SartoriDynamics/Reaction-Wheel-Balanced-Bicycle/Python codes/controle_vel.pdf

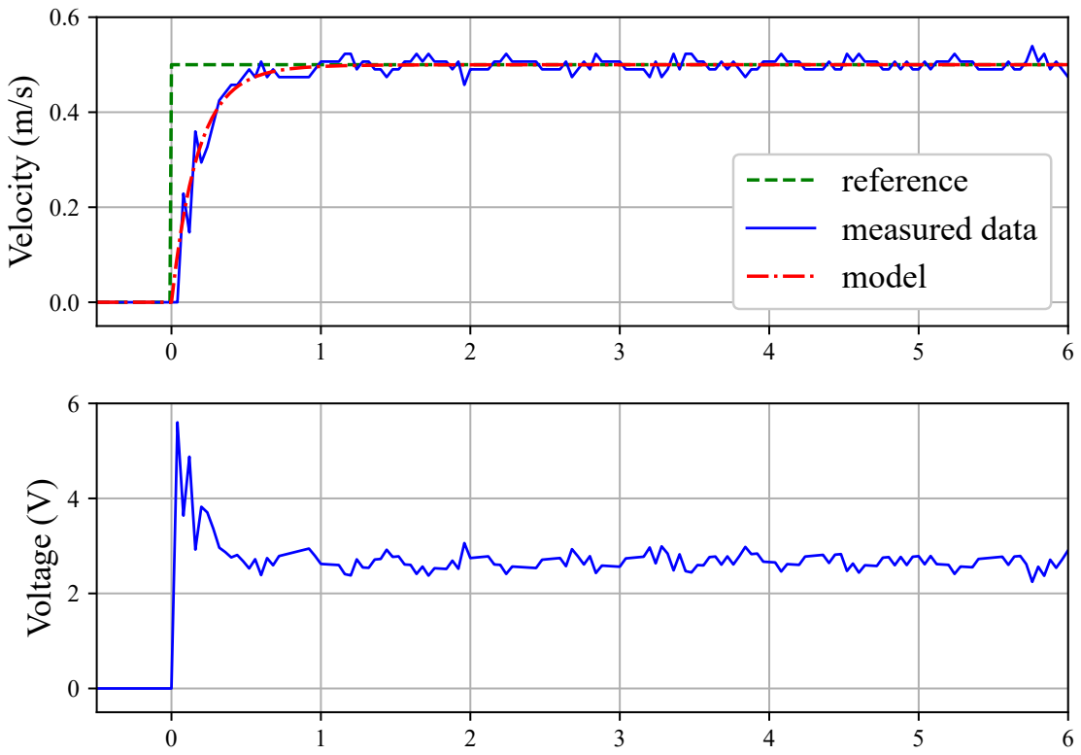
[picture p3: figure]
Velocity (m/s); reference measured data model; Voltage (V)
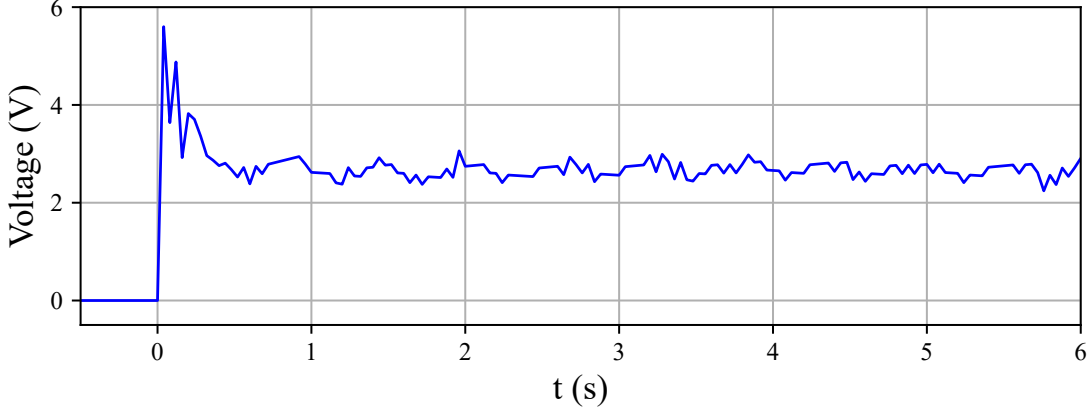
[picture p4: figure]
