SartoriDynamics/Reaction-Wheel-Balanced-Bicycle/3D printing files/Extra/rear_wheel_axle.stl

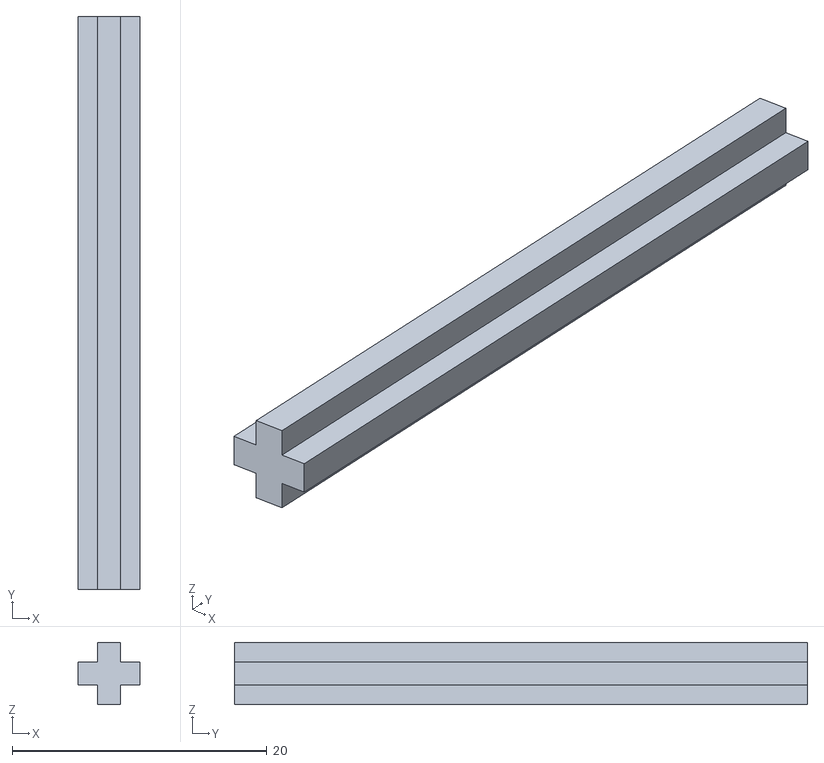
[picture p5: CAD file, 2026-11-06]
3D printing files/Extra/rear_wheel_axle.stl
4.90 x 45.0 x 4.90
