SartoriDynamics/Reaction-Wheel-Balanced-Bicycle/3D printing files/pulley_spacer.stl

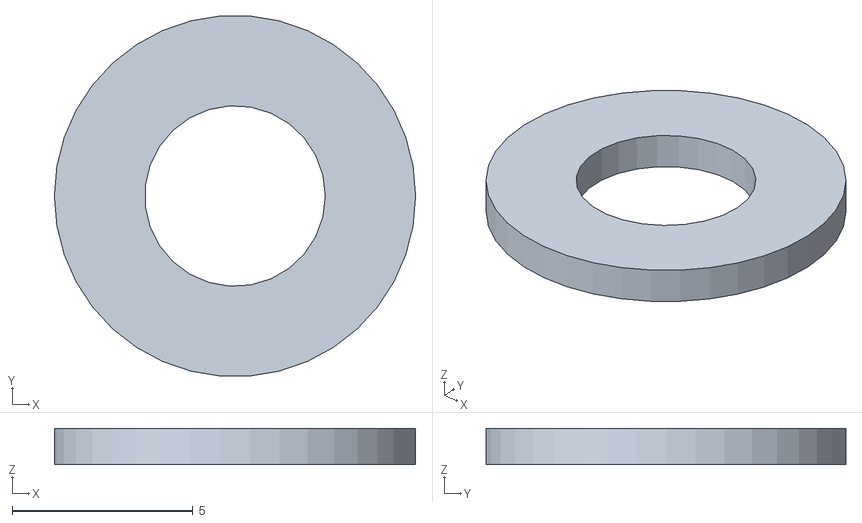
[picture p6: CAD file, 2026-11-06]
3D printing files/pulley_spacer.stl
10.0 x 9.97 x 1.00
