SartoriDynamics/Reaction-Wheel-Balanced-Bicycle/3D printing files/Extra/front_wheel_axle.stl

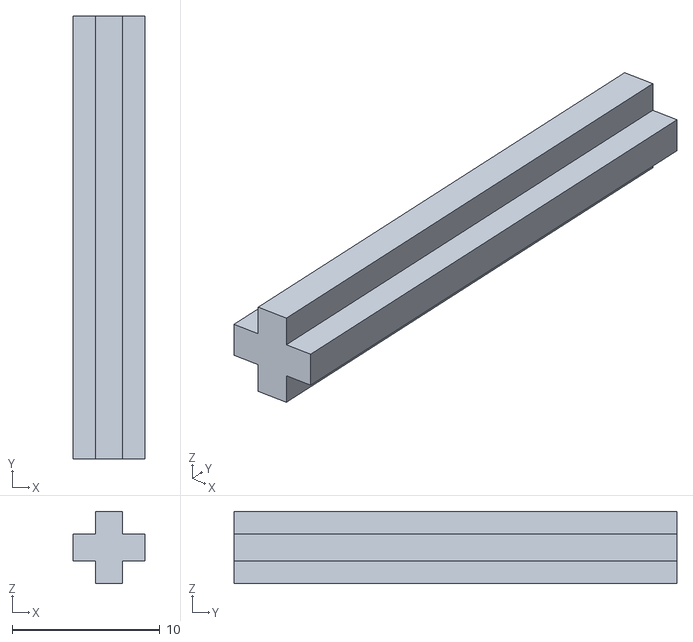
[picture p7: CAD file, 2026-11-06]
3D printing files/Extra/front_wheel_axle.stl
4.90 x 30.0 x 4.90
