SartoriDynamics/Reaction-Wheel-Balanced-Bicycle/3D printing files/rear_wheel_pulley.stl

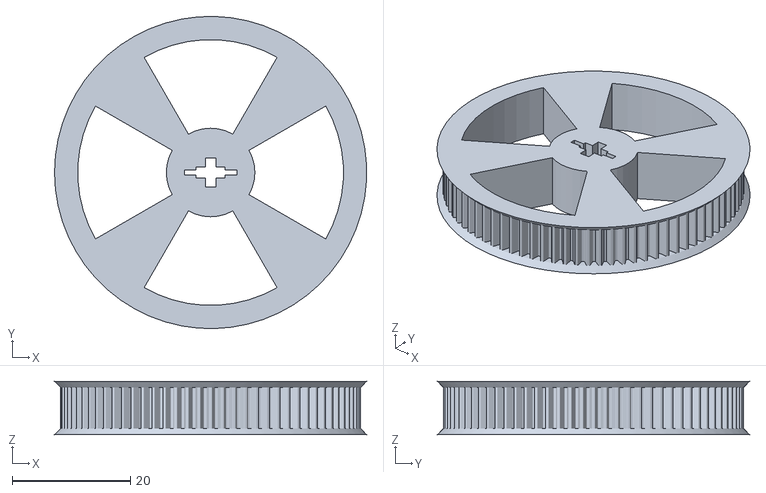
[picture p8: CAD file, 2026-11-06]
3D printing files/rear_wheel_pulley.stl
52.8 x 52.8 x 9.00
