SartoriDynamics/Reaction-Wheel-Balanced-Bicycle/3D printing files/Extra/wheel.stl

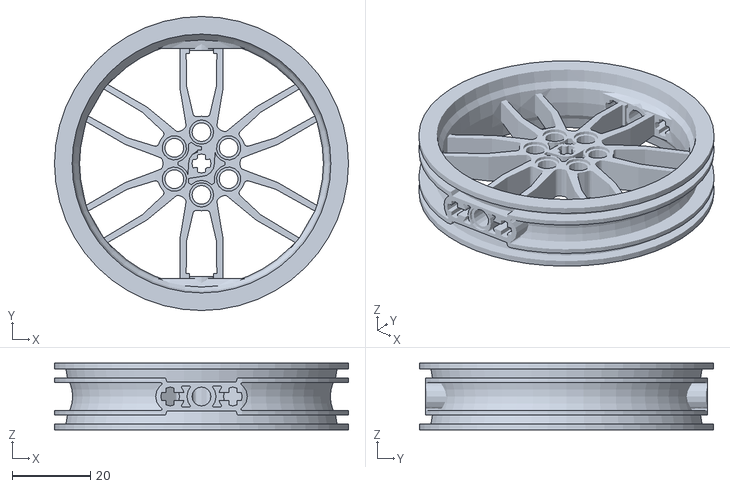
[picture p9: CAD file, 2026-11-06]
3D printing files/Extra/wheel.stl
75.0 x 75.0 x 17.0
