SartoriDynamics/Reaction-Wheel-Balanced-Bicycle/3D printing files/rear_servo_mount.stl

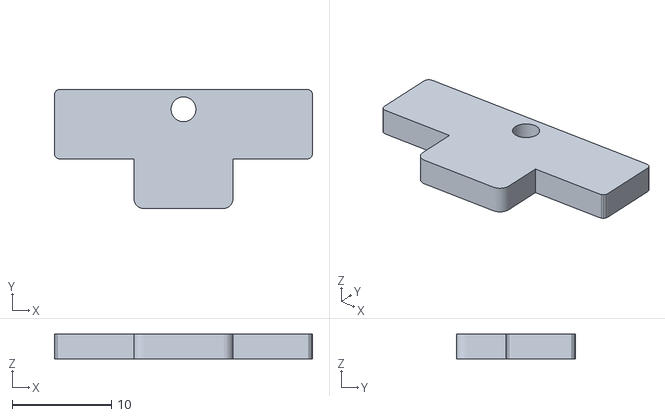
[picture p10: CAD file, 2026-11-06]
3D printing files/rear_servo_mount.stl
26.0 x 12.0 x 2.50
