SartoriDynamics/Reaction-Wheel-Balanced-Bicycle/3D printing files/Extra/tire.stl

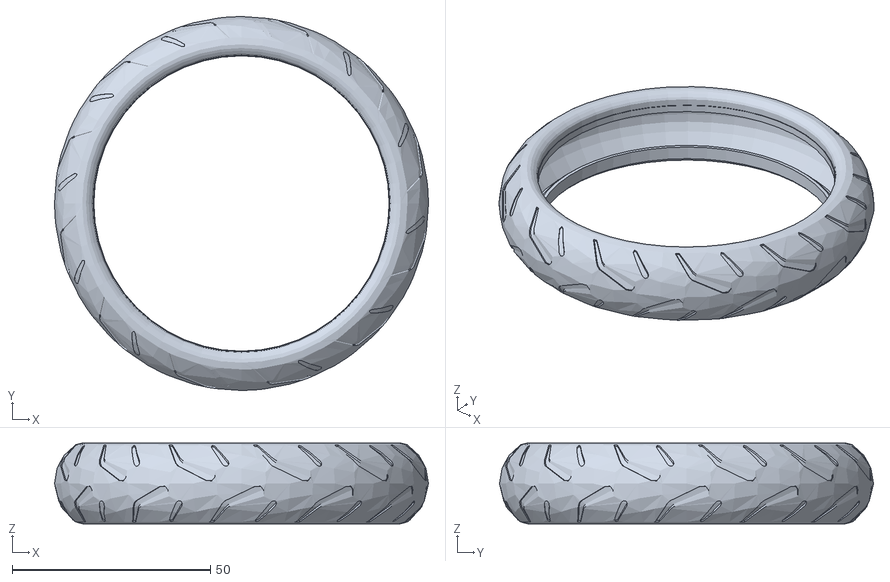
[picture p11: CAD file, 2026-11-06]
3D printing files/Extra/tire.stl
94.3 x 94.3 x 20.4
