SartoriDynamics/Reaction-Wheel-Balanced-Bicycle/3D printing files/motor_mounting_plate.stl

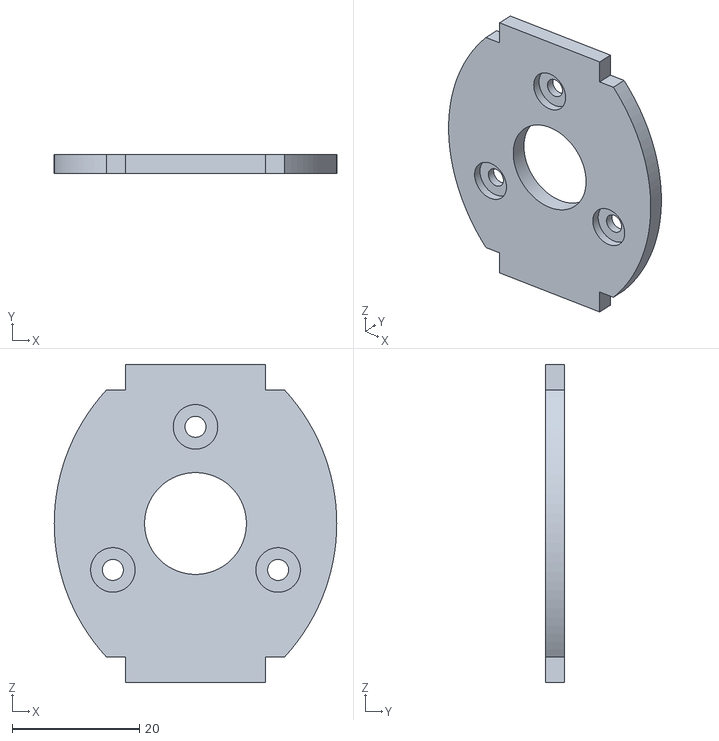
[picture p12: CAD file, 2026-11-06]
3D printing files/motor_mounting_plate.stl
44.4 x 3.00 x 50.0
