SartoriDynamics/Reaction-Wheel-Balanced-Bicycle/3D printing files/front_servo_mount.stl

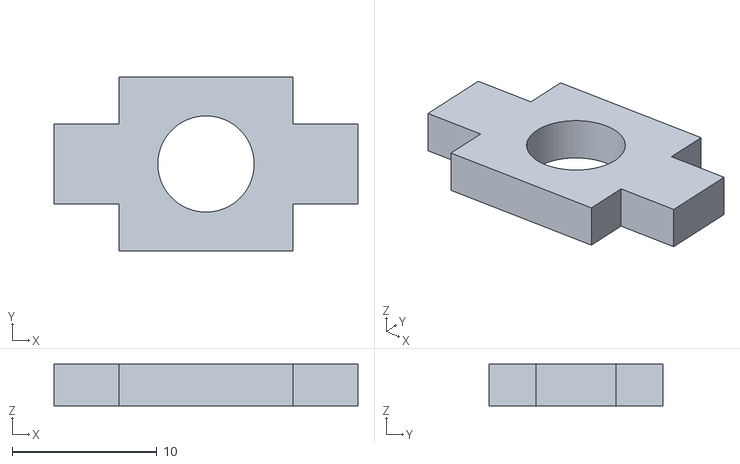
[picture p13: CAD file, 2026-11-06]
3D printing files/front_servo_mount.stl
21.0 x 12.0 x 2.90
