SartoriDynamics/Reaction-Wheel-Balanced-Bicycle/3D printing files/motor_drive_hub.stl

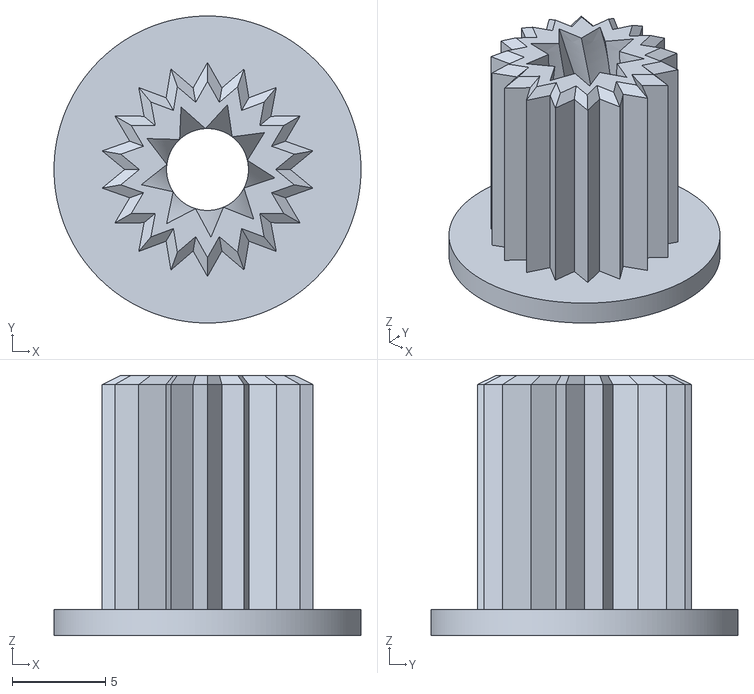
[picture p14: CAD file, 2026-11-06]
3D printing files/motor_drive_hub.stl
16.5 x 16.5 x 14.0
