SartoriDynamics/Reaction-Wheel-Balanced-Bicycle/3D printing files/left_frame_plate.stl

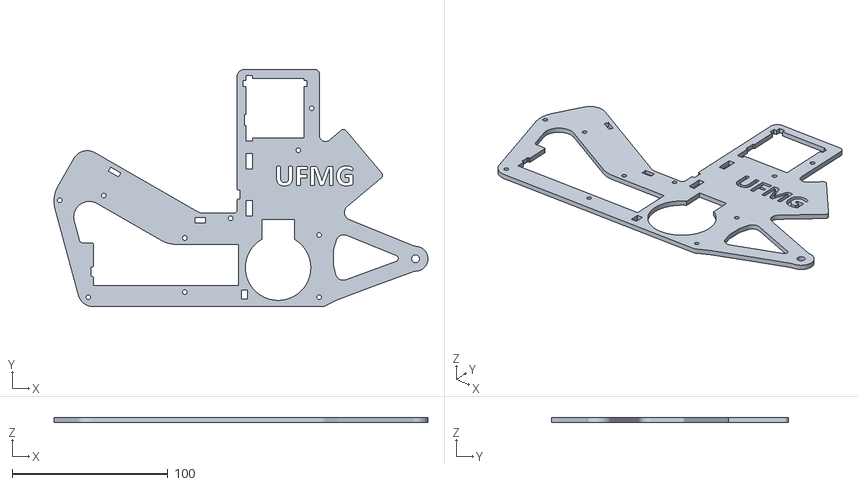
[picture p15: CAD file, 2026-11-06]
3D printing files/left_frame_plate.stl
240.4 x 152.5 x 3.00
