SartoriDynamics/Reaction-Wheel-Balanced-Bicycle/3D printing files/lower_servo_mount.stl

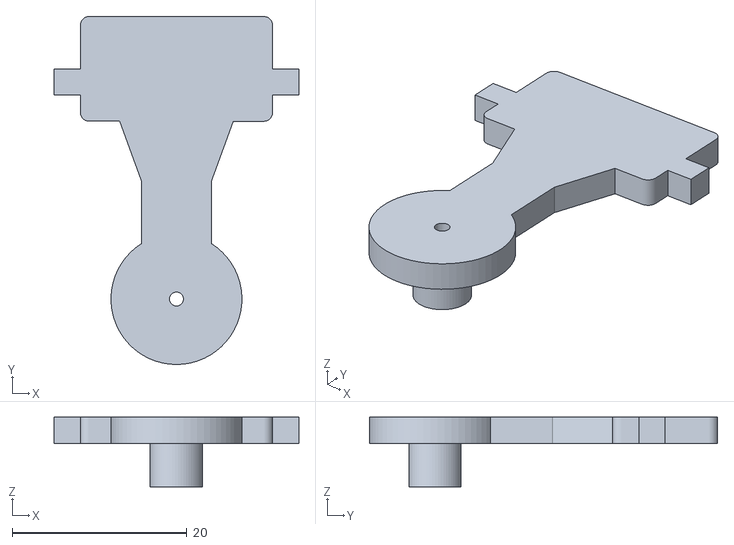
[picture p16: CAD file, 2026-11-06]
3D printing files/lower_servo_mount.stl
28.0 x 39.8 x 8.00
