SartoriDynamics/Reaction-Wheel-Balanced-Bicycle/3D printing files/right_frame_plate.stl

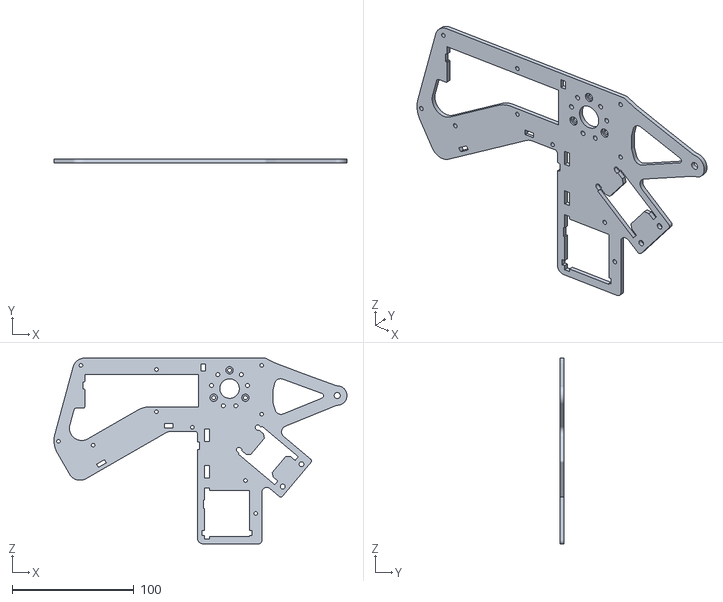
[picture p17: CAD file, 2026-11-06]
3D printing files/right_frame_plate.stl
240.4 x 3.00 x 152.5
