SartoriDynamics/Reaction-Wheel-Balanced-Bicycle/3D printing files/reaction_wheel.stl

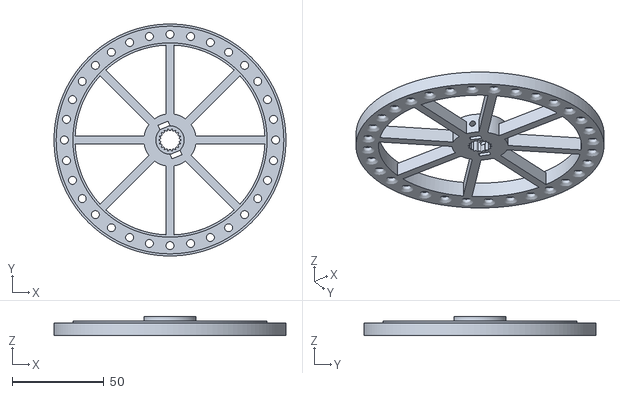
[picture p18: CAD file, 2026-11-06]
3D printing files/reaction_wheel.stl
126.4 x 126.4 x 10.5
