SartoriDynamics/Reaction-Wheel-Balanced-Bicycle/3D printing files/upper_servo_mount.stl

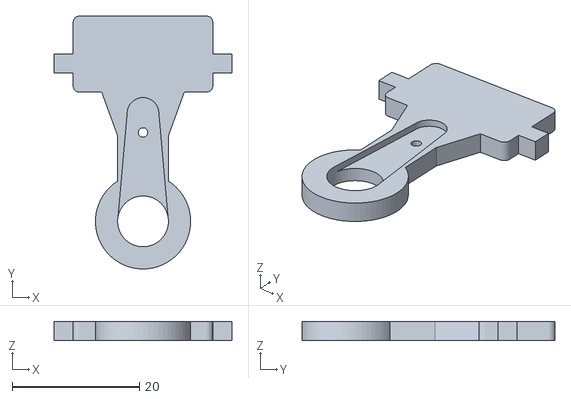
[picture p19: CAD file, 2026-11-06]
3D printing files/upper_servo_mount.stl
28.0 x 39.8 x 3.00
