SartoriDynamics/Reaction-Wheel-Balanced-Bicycle/3D printing files/fork_leg.stl

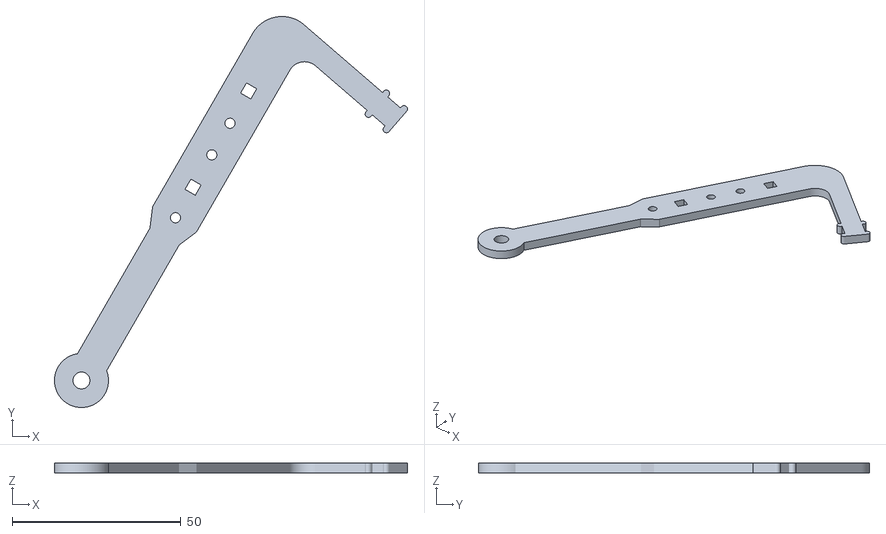
[picture p20: CAD file, 2026-11-06]
3D printing files/fork_leg.stl
104.5 x 115.8 x 3.00
