SartoriDynamics/Reaction-Wheel-Balanced-Bicycle/3D printing files/side_servo_mount.stl

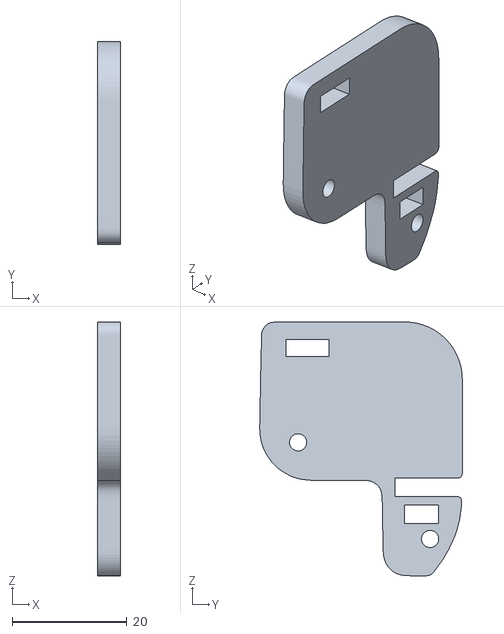
[picture p21: CAD file, 2026-11-06]
3D printing files/side_servo_mount.stl
4.00 x 35.4 x 44.3
