SartoriDynamics/Reaction-Wheel-Balanced-Bicycle/3D printing files/wheel_spacer.stl

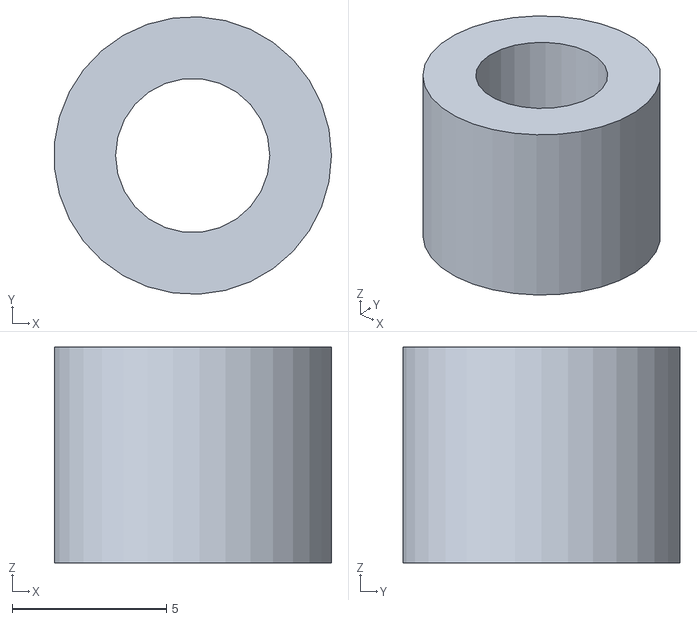
[picture p22: CAD file, 2026-11-06]
3D printing files/wheel_spacer.stl
8.98 x 8.99 x 7.00
