SartoriDynamics/Reaction-Wheel-Balanced-Bicycle/3D printing files/voltage_regulator_mount.stl

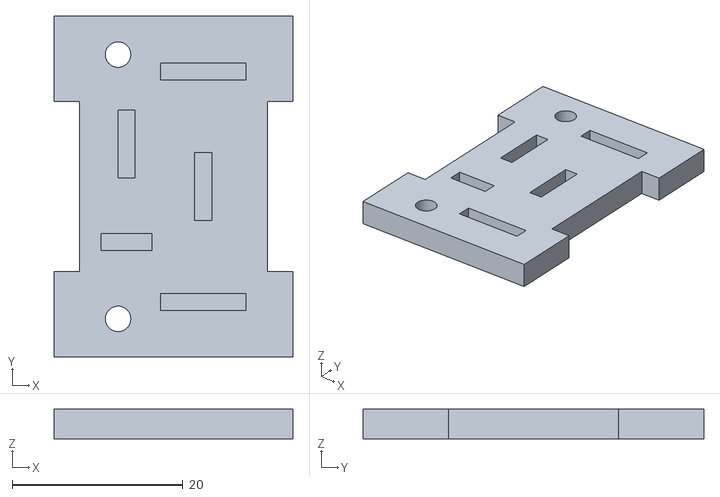
[picture p23: CAD file, 2026-11-06]
3D printing files/voltage_regulator_mount.stl
28.0 x 40.0 x 3.50
