SartoriDynamics/Reaction-Wheel-Balanced-Bicycle/3D printing files/support_stand.stl

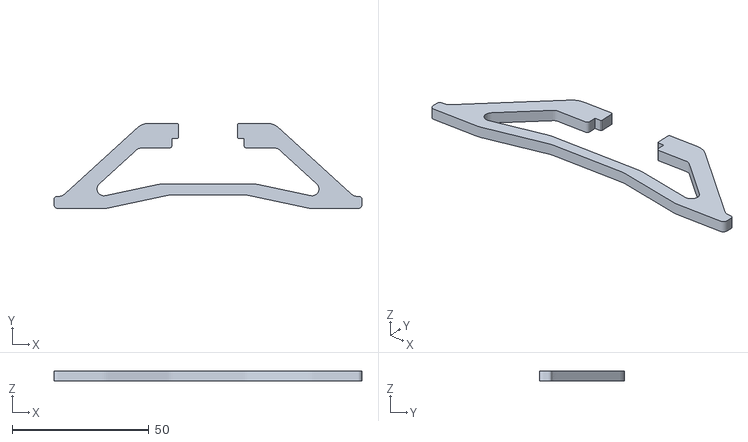
[picture p24: CAD file, 2026-11-06]
3D printing files/support_stand.stl
112.7 x 31.2 x 3.60
