SartoriDynamics/Reaction-Wheel-Balanced-Bicycle/3D printing files/IMU_mount.stl

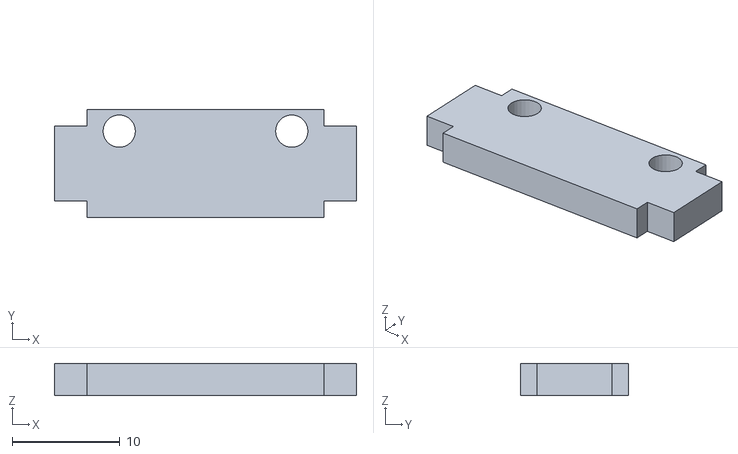
[picture p25: CAD file, 2026-11-06]
3D printing files/IMU_mount.stl
28.0 x 10.00 x 3.00
