SartoriDynamics/Reaction-Wheel-Balanced-Bicycle/Python codes/modelo_vel.pdf

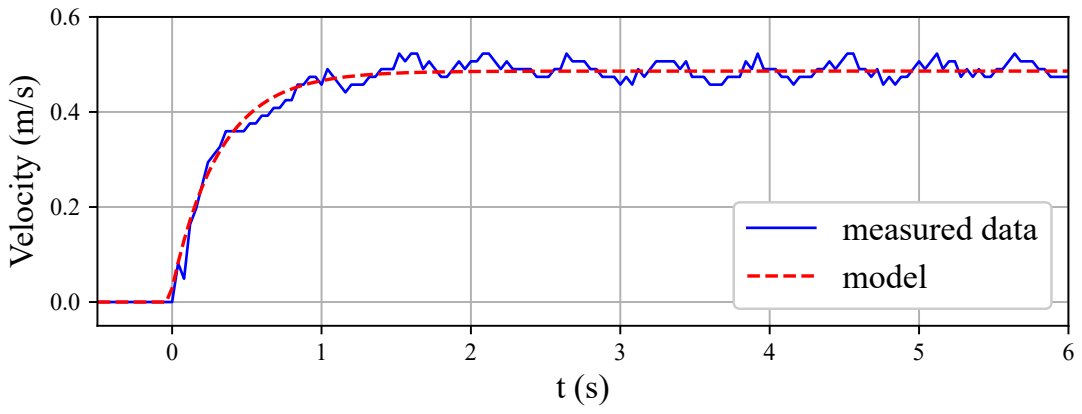
[picture p26: page 1]
Velocity (m/s); measured data model
