SartoriDynamics/Reaction-Wheel-Balanced-Bicycle/(commit log)

2026-11-06 Name changes
    [IMU_holder.stl, Nidec_gear.stl, Nidec_holder.stl, flywheel.stl, fork.stl, front_wheel_axle.stl, gear_spacer.stl, left_body.stl]
2026-11-06 Add PI velocity control experiment to README
    Added a new experimental PI velocity control sketch to the README.
